ScherbakovAl/PIANO_G4_cbt6/ibis model/stm32g4_ibis/readme.txt

************************************************************************************
* @file     Readme.txt                                                              
* @author   MCD Application Team                                                    
* @version  V4.0                                                                    
* @date     29-July-2024                                                          
* @brief    I/O Buffer Information Specification (IBIS) files for the STM32G4 MCUs.    
************************************************************************************
* COPYRIGHT(c) 2024 STMicroelectronics                                             
*                                                                                  
* Redistribution and use in source and binary forms, with or without modification, 
* are permitted provided that the following conditions are met:                    
*   1. Redistributions of source code must retain the above copyright notice,      
*      this list of conditions and the following disclaimer.                       
*   2. Redistributions in binary form must reproduce the above copyright notice,   
*      this list of conditions and the following disclaimer in the documentation  
*      and/or other materials provided with the distribution.                      
*   3. Neither the name of STMicroelectronics nor the names of its contributors    
*      may be used to endorse or promote products derived from this software       
*      without specific prior written permission.                                  
*                                                                                  
* THIS SOFTWARE IS PROVIDED BY THE COPYRIGHT HOLDERS AND CONTRIBUTORS "AS IS"      
* AND ANY EXPRESS OR IMPLIED WARRANTIES, INCLUDING, BUT NOT LIMITED TO, THE        
* IMPLIED WARRANTIES OF MERCHANTABILITY AND FITNESS FOR A PARTICULAR PURPOSE ARE   
* DISCLAIMED. IN NO EVENT SHALL THE COPYRIGHT HOLDER OR CONTRIBUTORS BE LIABLE     
* FOR ANY DIRECT, INDIRECT, INCIDENTAL, SPECIAL, EXEMPLARY, OR CONSEQUENTIAL       
* DAMAGES (INCLUDING, BUT NOT LIMITED TO, PROCUREMENT OF SUBSTITUTE GOODS OR       
* SERVICES; LOSS OF USE, DATA, OR PROFITS; OR BUSINESS INTERRUPTION) HOWEVER       
* CAUSED AND ON ANY THEORY OF LIABILITY, WHETHER IN CONTRACT, STRICT LIABILITY,    
* OR TORT (INCLUDING NEGLIGENCE OR OTHERWISE) ARISING IN ANY WAY OUT OF THE USE    
* OF THIS SOFTWARE, EVEN IF ADVISED OF THE POSSIBILITY OF SUCH DAMAGE.             
***********************************************************************************

===============================
IBIS files for STM32G4 devices:
===============================

The package contains :

   + IBIS Files for STM32G431_441 devices on different packages :

	  o LQFP100
	  o LQFP80
	  o LQFP64
	  o LQFP48
	  o LQFP32
	  o UFBGA64
	  o UFQFPN48
	  o UFQFPN32
	  o WLCSP49

   + IBIS Files for STM32G471_473_474_483_484 devices on different packages :

          o LQFP128
	  o LQFP100
	  o LQFP80
	  o LQFP64
	  o LQFP48
	  o TFBGA100
	  o UFQFPN48
	  o WLCSP81
	  
   + IBIS Files for STM32G491_4A1 devices on different packages :

	  o LQFP100
	  o LQFP80
	  o LQFP64
	  o LQFP48
	  o UFBGA64
	  o UFQFPN48
	  o UFQFPN32
	  o WLCSP64
	  
=========================
* V4.0 - 29-July-2024  
=========================
 + Updating the naming of IBIS files for STM32G491_4a1 devices.
 + Updating of IBIS files for STM32G491_4a1 devices specifically LQFP48 package.
 + Updating of IBIS files for STM32G471_473_474_483_484 devices specifically LQFP48 package.

=========================
* V3.0 - 12-February-2021  
=========================
    + Created with IBIS files for STM32G4a1 devices.
	
=====================
* V2.0 - 24-July 2020 
=====================
    + Created with IBIS files for STM32G491 devices.
	
=====================
* V1.0 - 19-July-2019 
=====================
    + Created with IBIS files for STM32G471_473_474_483_484 and STM32G431_441 devices.

************** (C) COPYRIGHT 2024 STMicroelectronics **************
                          END OF FILE
