ScherbakovAl/PIANO_G4_cbt6/G4_bootloader/ПЕРЕХОД_C_CPP.md

# Объяснение ошибок при переходе с .c на .cpp

## Основные причины ошибок

Когда вы меняете расширение файла с `.c` на `.cpp`, компилятор переключается с C на C++, и это приводит к следующим проблемам:

### 1. **Name Mangling (Искажение имен)**

В C++ компилятор изменяет имена функций для поддержки перегрузки функций. Например:
- C: `void myFunction()` → `myFunction`
- C++: `void myFunction()` → `_Z10myFunctionv`

**Решение:** Использовать `extern "C"` для функций, которые должны вызываться из C кода:

```cpp
#ifdef __cplusplus
extern "C" {
#endif

void g4_bootloader();
void USART2_IRQ();
// ... другие функции

#ifdef __cplusplus
}
#endif
```

### 2. **Строгая типизация**

C++ гораздо строже проверяет типы, чем C:

#### Проблема с volatile указателями:
```cpp
volatile uint8_t* ChipNumber;
uint8_t* pData;

// В C работает:
Read(Address, ChipNumber, Size);

// В C++ ошибка: invalid conversion from 'volatile uint8_t*' to 'uint8_t*'
```

**Решение:** Использовать `const_cast`:
```cpp
Read(Address, const_cast<uint8_t*>(ChipNumber), Size);
```

#### Проблема с несовместимыми типами указателей:
```cpp
uint8_t* ChipN;   // указатель на uint8_t
uint64_t* Data;   // указатель на uint64_t

// В C работает (с предупреждением):
Flash(Address, ChipN, Size);

// В C++ ошибка: cannot convert 'uint8_t*' to 'uint64_t*'
```

**Решение:** Использовать `reinterpret_cast`:
```cpp
Flash(Address, reinterpret_cast<uint64_t*>(ChipN), Size);
```

### 3. **Настройка системы сборки CMake**

При использовании C++ необходимо:

1. **Включить поддержку C++:**
```cmake
enable_language(C CXX ASM)
```

2. **Установить стандарт C++:**
```cmake
set(CMAKE_CXX_STANDARD 17)
set(CMAKE_CXX_STANDARD_REQUIRED ON)
set(CMAKE_CXX_EXTENSIONS ON)
```

3. **Обновить список исходных файлов:**
```cmake
target_sources(${CMAKE_PROJECT_NAME} PRIVATE
    Core/Src/g4_bootloader.cpp  # было .c
)
```

4. **Использовать правильный тулчейн при конфигурации:**
```bash
cmake -B build -DCMAKE_TOOLCHAIN_FILE=cmake/gcc-arm-none-eabi.cmake
```

## Выполненные изменения

### 1. [`CMakeLists.txt`](CMakeLists.txt)
- Добавлена поддержка C++ (`enable_language(C CXX ASM)`)
- Установлен стандарт C++17
- Изменен путь к файлу с `.c` на `.cpp`

### 2. [`Core/Inc/g4_bootloader.h`](Core/Inc/g4_bootloader.h)
- Добавлена декларация `void g4_bootloader();` в блок `extern "C"`
- Все функции уже были внутри `extern "C"` блока, что правильно

### 3. [`Core/Src/g4_bootloader.cpp`](Core/Src/g4_bootloader.cpp)
- Использован `const_cast<uint8_t*>(ChipNumber)` для преобразования volatile указателя
- Использован `reinterpret_cast<uint64_t*>(ChipN)` для преобразования типов указателей

## Рекомендации

### Использование C++ в встраиваемых системах

**Преимущества:**
- Классы и инкапсуляция
- Шаблоны для типобезопасного кода
- RAII для управления ресурсами
- Перегрузка функций и операторов

**Что нужно отключать:**
```cmake
set(CMAKE_CXX_FLAGS "${CMAKE_C_FLAGS} -fno-rtti -fno-exceptions -fno-threadsafe-statics")
```
- `-fno-rtti` - отключает RTTI (Run-Time Type Information)
- `-fno-exceptions` - отключает исключения
- `-fno-threadsafe-statics` - отключает защиту статических переменных в многопоточной среде

### Осторожно с приведением типов

Использование `reinterpret_cast` для преобразования `uint8_t*` в `uint64_t*` может быть опасным:

```cpp
// Лучше создать правильный тип сразу:
uint64_t ChipN_aligned = ChipN[0];
Flash(ADRESS_CHIP_NUMBER, &ChipN_aligned, sizeof(uint64_t));
```

Или изменить сигнатуру функции:
```cpp
void Flash(uint32_t Address, void* Data, uint32_t size);
```

## Полезные ссылки

- [C++ для встраиваемых систем](https://isocpp.org/wiki/faq/embedded-systems)
- [Mixing C and C++](https://isocpp.org/wiki/faq/mixing-c-and-cpp)
- [CMake для ARM](https://cmake.org/cmake/help/latest/manual/cmake-toolchains.7.html)
