ScherbakovAl/PIANO_G4_cbt6/pcb/PNG_G4/PCB_G4.png

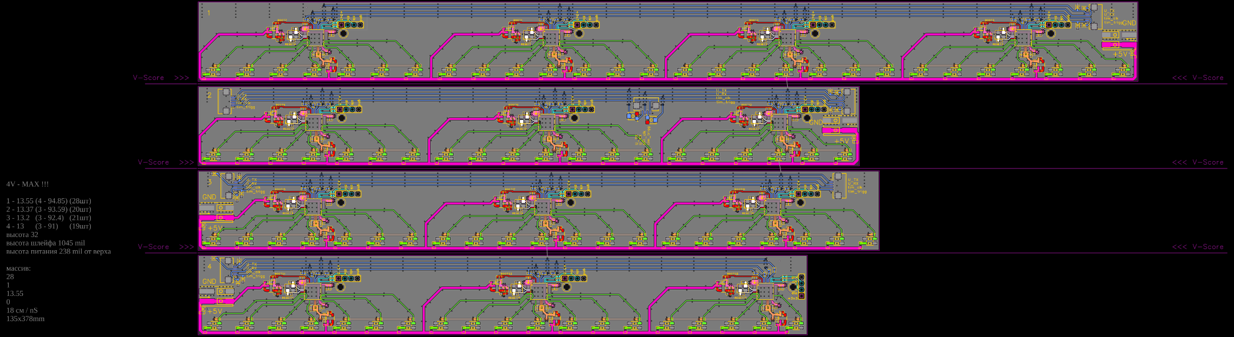
pcb/PNG_G4/PCB_G4.png
