ScherbakovAl/PIANO_G4_cbt6/pcb/PNG_G4/Schematic1/SCH_Schematic1_1-P1/SCH_reus5_1-P1_2026-06-18.png

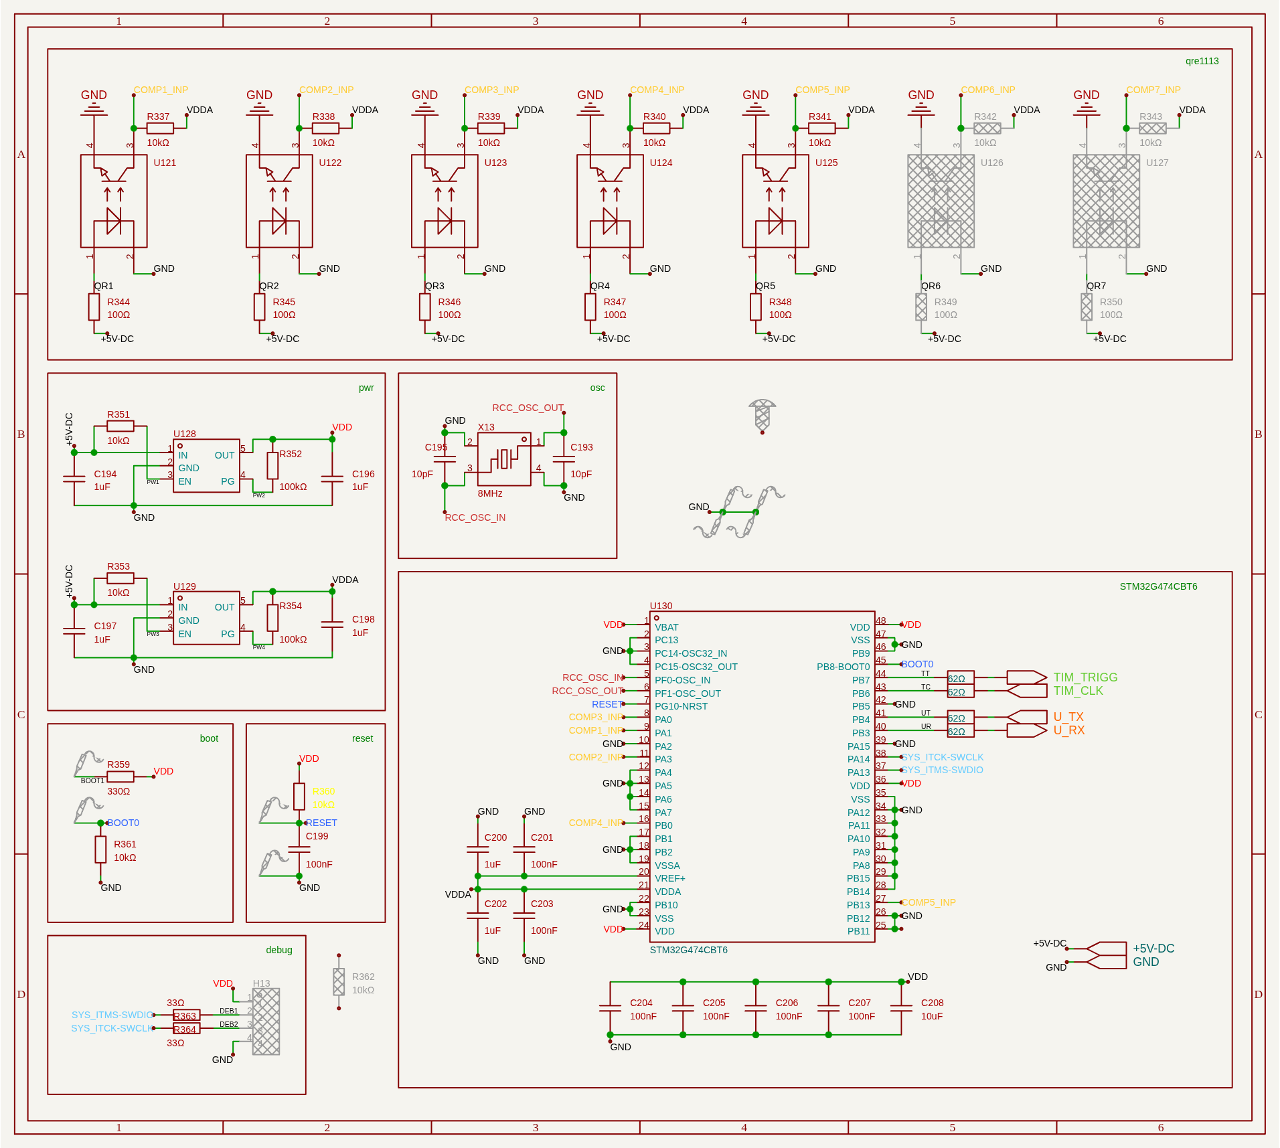
pcb/PNG_G4/Schematic1/SCH_Schematic1_1-P1/SCH_reus5_1-P1_2026-06-18.png
