ScherbakovAl/PIANO_G4_cbt6/pcb/PNG_G4/Schematic1/SCH_Schematic1_1-P1/SCH_reus_1-sch_2026-06-18_5.png

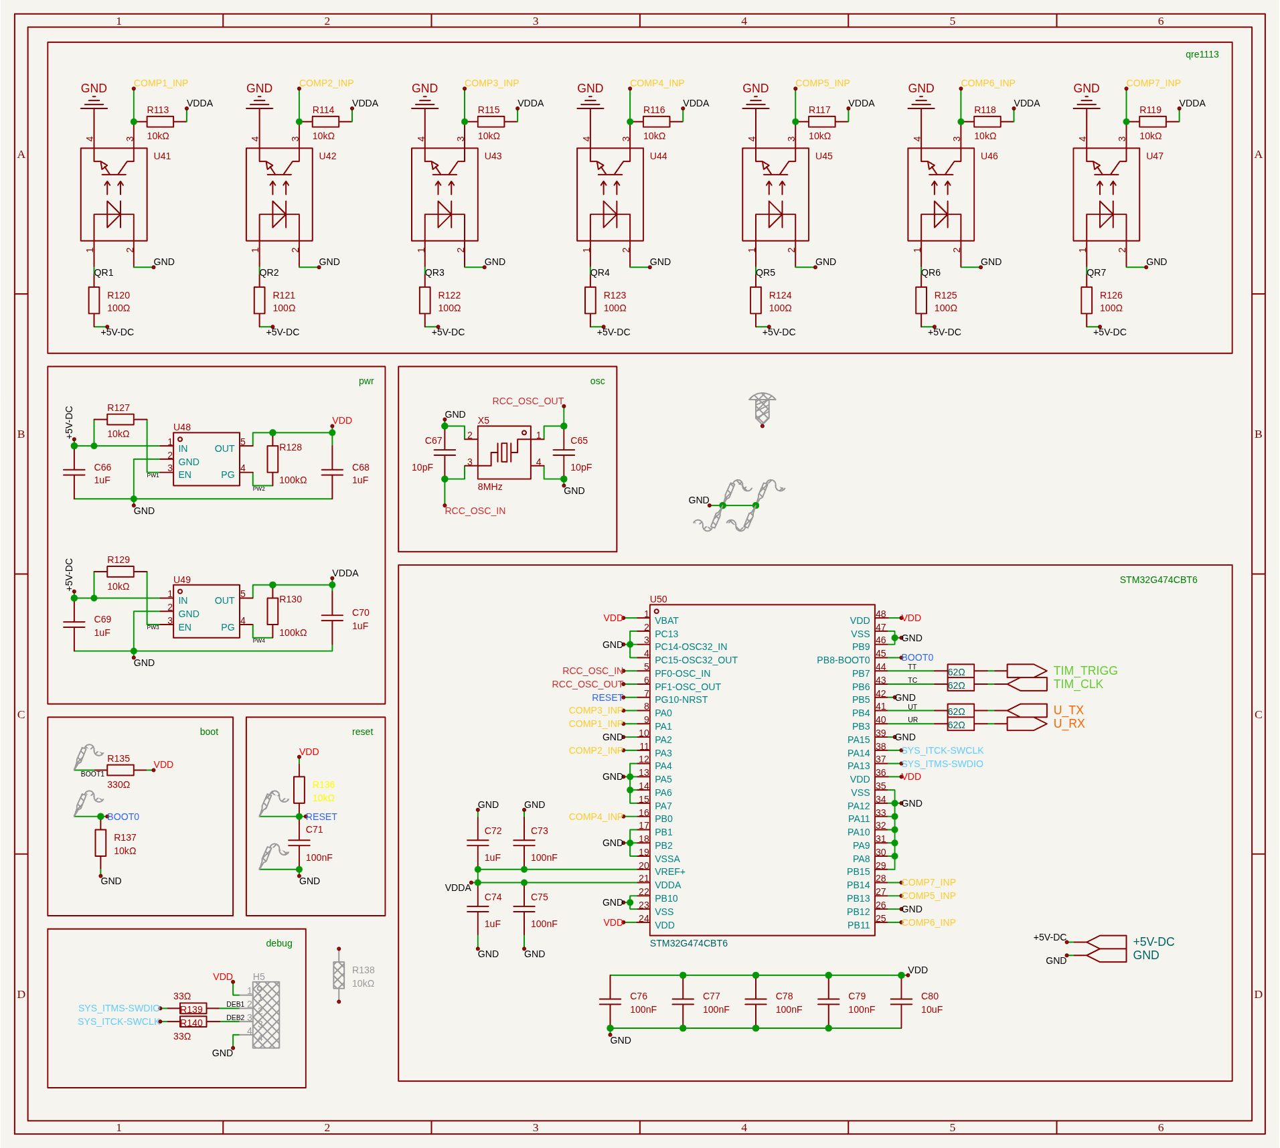
pcb/PNG_G4/Schematic1/SCH_Schematic1_1-P1/SCH_reus_1-sch_2026-06-18_5.png
