ScherbakovAl/PIANO_G4_cbt6/pcb/PNG_piano_boards_v1.0_(made)_G4/PCB_reus_G4.png

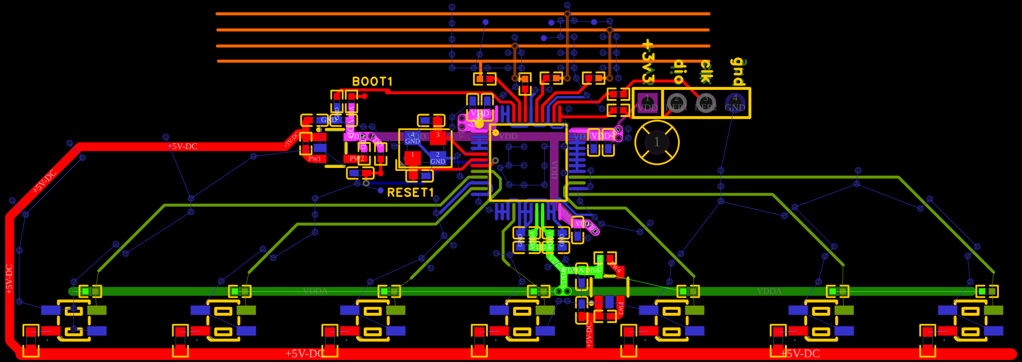
pcb/PNG_piano_boards_v1.0_(made)_G4/PCB_reus_G4.png
