ScherbakovAl/PIANO_G4_cbt6/pcb/PNG_piano_boards_v1.0_(made)_G4/Schematic1/SCH_Schematic1 1-P1/SCH_reus_1-sch_2026-06-18.png

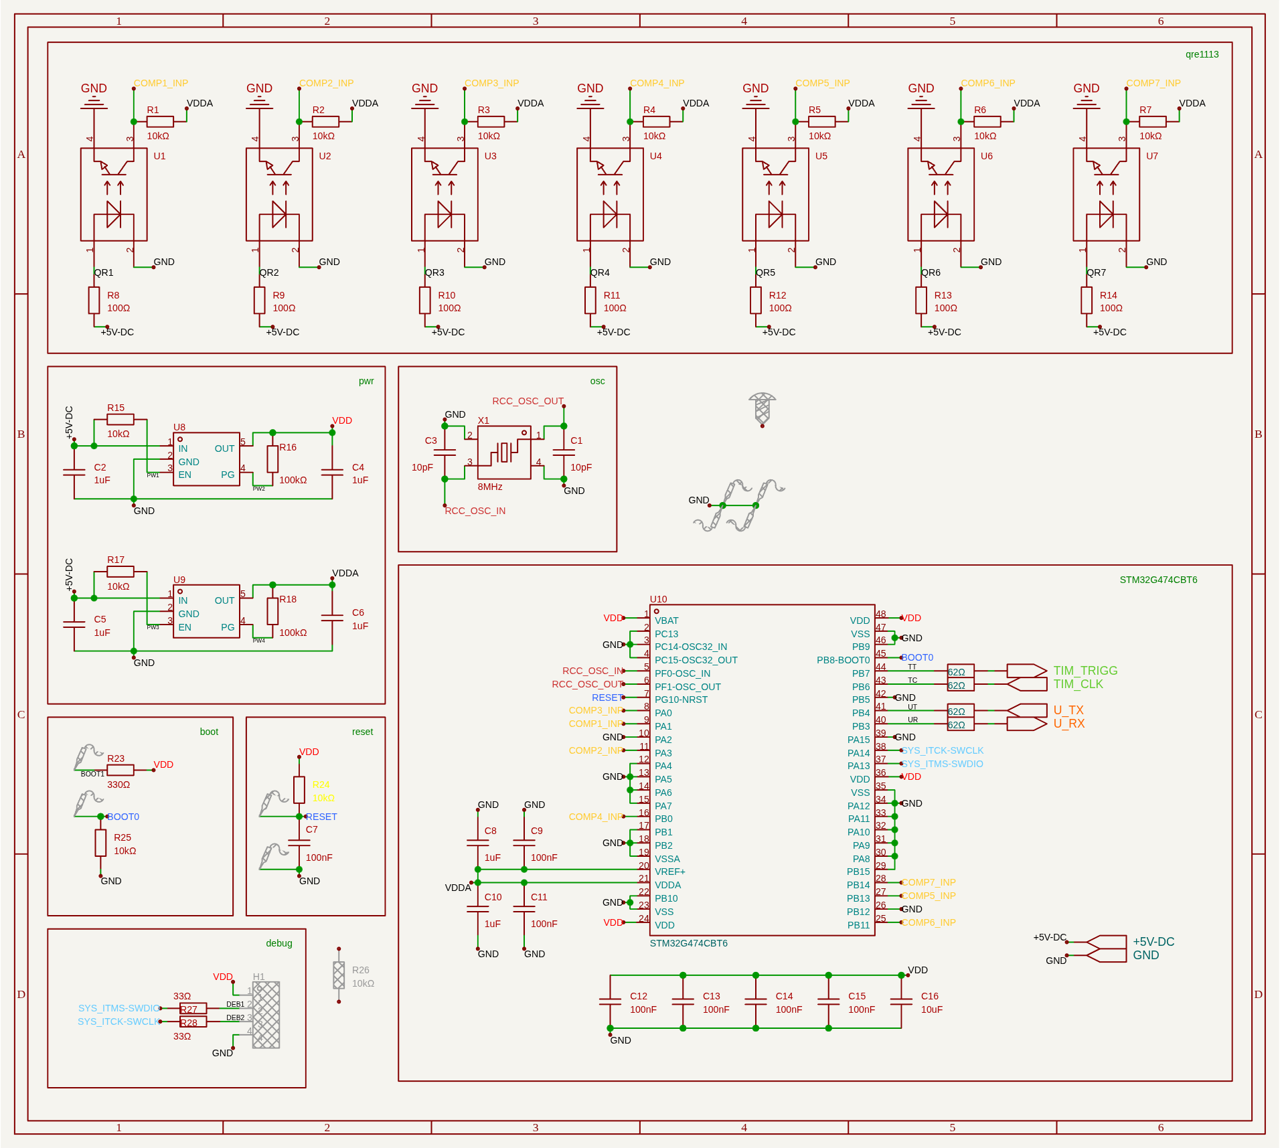
pcb/PNG_piano_boards_v1.0_(made)_G4/Schematic1/SCH_Schematic1 1-P1/SCH_reus_1-sch_2026-06-18.png
