ScherbakovAl/PIANO_G4_cbt6/pcb/BOM_Board_v1.0_Schematic_G4.xlsx

No. | Quantity | Comment | Designator | Footprint | Value | Manufacturer Part | Manufacturer | Supplier Part | Supplier
1 | 13 | oc2 | C1,C17,C33,C49,C65,C81,C97,C113,C129,C145,C161,C177,C193 | C0402 | 10pF | CC0402JRNPO9BN100 | YAGEO(国巨) | C106199 | LCSC
2 | 13 | p1c1 | C2,C18,C34,C50,C66,C82,C98,C114,C130,C146,C162,C178,C194 | C0402 | 1uF | CL05A105KA5NQNC | SAMSUNG(三星) | C52923 | LCSC
3 | 13 | oc1 | C3,C19,C35,C51,C67,C83,C99,C115,C131,C147,C163,C179,C195 | C0402 | 10pF | CC0402JRNPO9BN100 | YAGEO(国巨) | C106199 | LCSC
4 | 13 | p1c2 | C4,C20,C36,C52,C68,C84,C100,C116,C132,C148,C164,C180,C196 | C0402 | 1uF | CL05A105KA5NQNC | SAMSUNG(三星) | C52923 | LCSC
5 | 13 | p2c1 | C5,C21,C37,C53,C69,C85,C101,C117,C133,C149,C165,C181,C197 | C0402 | 1uF | CL05A105KA5NQNC | SAMSUNG(三星) | C52923 | LCSC
6 | 13 | p2c2 | C6,C22,C38,C54,C70,C86,C102,C118,C134,C150,C166,C182,C198 | C0402 | 1uF | CL05A105KA5NQNC | SAMSUNG(三星) | C52923 | LCSC
7 | 13 | rc | C7,C23,C39,C55,C71,C87,C103,C119,C135,C151,C167,C183,C199 | C0402 | 100nF | CL05B104KO5NNNC | SAMSUNG(三星) | C1525 | LCSC
8 | 13 | sc1 | C8,C24,C40,C56,C72,C88,C104,C120,C136,C152,C168,C184,C200 | C0402 | 1uF | CL05A105KA5NQNC | SAMSUNG(三星) | C52923 | LCSC
9 | 13 | sc2 | C9,C25,C41,C57,C73,C89,C105,C121,C137,C153,C169,C185,C201 | C0402 | 100nF | CL05B104KO5NNNC | SAMSUNG(三星) | C1525 | LCSC
10 | 13 | sc3 | C10,C26,C42,C58,C74,C90,C106,C122,C138,C154,C170,C186,C202 | C0402 | 1uF | CL05A105KA5NQNC | SAMSUNG(三星) | C52923 | LCSC
11 | 13 | sc4 | C11,C27,C43,C59,C75,C91,C107,C123,C139,C155,C171,C187,C203 | C0402 | 100nF | CL05B104KO5NNNC | SAMSUNG(三星) | C1525 | LCSC
12 | 13 | sc5 | C12,C28,C44,C60,C76,C92,C108,C124,C140,C156,C172,C188,C204 | C0402 | 100nF | CL05B104KO5NNNC | SAMSUNG(三星) | C1525 | LCSC
13 | 13 | sc6 | C13,C29,C45,C61,C77,C93,C109,C125,C141,C157,C173,C189,C205 | C0402 | 100nF | CL05B104KO5NNNC | SAMSUNG(三星) | C1525 | LCSC
14 | 13 | sc7 | C14,C30,C46,C62,C78,C94,C110,C126,C142,C158,C174,C190,C206 | C0402 | 100nF | CL05B104KO5NNNC | SAMSUNG(三星) | C1525 | LCSC
15 | 13 | sc8 | C15,C31,C47,C63,C79,C95,C111,C127,C143,C159,C175,C191,C207 | C0402 | 100nF | CL05B104KO5NNNC | SAMSUNG(三星) | C1525 | LCSC
16 | 13 | sc9 | C16,C32,C48,C64,C80,C96,C112,C128,C144,C160,C176,C192,C208 | C0402 | 10uF | CL05A106MQ5NUNC | SAMSUNG(三星) | C15525 | LCSC
17 | 4 | 4.7uF | C209,C210,C211,C212 | C0402 | 4.7uF | CL05A475MO5NUNC | SAMSUNG(三星) | C318563 | LCSC
18 | 16 | CDSOD323-T03C | D4,D5,D6,D8,D10,D11,D12,D13,D15,D16,D17,D19,D21,D22,D23,D24 | SOD-323_L1.8-W1.3-LS2.5-BI |  | CDSOD323-T03C | BOURNS | C711705 | LCSC
19 | 4 | CDSOD323-T05C | D7,D9,D18,D20 | SOD-323_L1.8-W1.3-LS2.5-BI |  | CDSOD323-T05C | BOURNS | C711706 | LCSC
20 | 88 | qr2 | R1,R2,R3,R4,R5,R6,R7,R29,R30,R31,R32,R33,R34,R35,R57,R58,R59,R60,R61,R62,R63,R85,R86,R87,R88,R89,R90,R91,R113,R114,R115,R116,R117,R118,R119,R141,R142,R143,R144,R145,R146,R147,R169,R170,R171,R172,R173,R174,R197,R198,R199,R200,R201,R202,R203,R225,R226,R227,R228,R229,R230,R231,R253,R254,R255,R256,R257,R258,R259,R281,R282,R283,R284,R285,R286,R287,R309,R310,R311,R312,R313,R314,R315,R337,R338,R339,R340,R341 | R0402 | 10kΩ | RC0402FR-0710KL | YAGEO(国巨) | C60490 | LCSC
21 | 88 | qr1 | R8,R9,R10,R11,R12,R13,R14,R36,R37,R38,R39,R40,R41,R42,R64,R65,R66,R67,R68,R69,R70,R92,R93,R94,R95,R96,R97,R98,R120,R121,R122,R123,R124,R125,R126,R148,R149,R150,R151,R152,R153,R154,R176,R177,R178,R179,R180,R181,R204,R205,R206,R207,R208,R209,R210,R232,R233,R234,R235,R236,R237,R238,R260,R261,R262,R263,R264,R265,R266,R288,R289,R290,R291,R292,R293,R294,R316,R317,R318,R319,R320,R321,R322,R344,R345,R346,R347,R348 | R0603 | 100Ω | RC0603FR-07100RL | YAGEO(国巨) | C105588 | LCSC
22 | 13 | p1r1 | R15,R43,R71,R99,R127,R155,R183,R211,R239,R267,R295,R323,R351 | R0402 | 10kΩ | RC0402FR-0710KL | YAGEO(国巨) | C60490 | LCSC
23 | 13 | p1r2 | R16,R44,R72,R100,R128,R156,R184,R212,R240,R268,R296,R324,R352 | R0402 | 100kΩ | RC0402FR-07100KL | YAGEO(国巨) | C60491 | LCSC
24 | 13 | p2r1 | R17,R45,R73,R101,R129,R157,R185,R213,R241,R269,R297,R325,R353 | R0402 | 10kΩ | RC0402FR-0710KL | YAGEO(国巨) | C60490 | LCSC
25 | 13 | p2r2 | R18,R46,R74,R102,R130,R158,R186,R214,R242,R270,R298,R326,R354 | R0402 | 100kΩ | RC0402FR-07100KL | YAGEO(国巨) | C60491 | LCSC
26 | 52 | 62Ω | R19,R20,R21,R22,R47,R48,R49,R50,R75,R76,R77,R78,R103,R104,R105,R106,R131,R132,R133,R134,R159,R160,R161,R162,R187,R188,R189,R190,R215,R216,R217,R218,R243,R244,R245,R246,R271,R272,R273,R274,R299,R300,R301,R302,R327,R328,R329,R330,R355,R356,R357,R358 | R0402 | 62Ω | FRC0402F62R0TS | FOJAN(富捷) | C2909376 | LCSC
27 | 13 | br1 | R23,R51,R79,R107,R135,R163,R191,R219,R247,R275,R303,R331,R359 | R0402 | 330Ω | RC0402FR-07330RL | YAGEO(国巨) | C105875 | LCSC
28 | 13 | rr | R24,R52,R80,R108,R136,R164,R192,R220,R248,R276,R304,R332,R360 | R0402 | 10kΩ | RC0402FR-0710KL | YAGEO(国巨) | C60490 | LCSC
29 | 13 | br2 | R25,R53,R81,R109,R137,R165,R193,R221,R249,R277,R305,R333,R361 | R0402 | 10kΩ | RC0402FR-0710KL | YAGEO(国巨) | C60490 | LCSC
30 | 13 | dr1 | R27,R55,R83,R111,R139,R167,R195,R223,R251,R279,R307,R335,R363 | R0402 | 33Ω | RC0402FR-0733RL | YAGEO(国巨) | C138002 | LCSC
31 | 13 | dr2 | R28,R56,R84,R112,R140,R168,R196,R224,R252,R280,R308,R336,R364 | R0402 | 33Ω | RC0402FR-0733RL | YAGEO(国巨) | C138002 | LCSC
32 | 88 | q | U1,U2,U3,U4,U5,U6,U7,U11,U12,U13,U14,U15,U16,U17,U21,U22,U23,U24,U25,U26,U27,U31,U32,U33,U34,U35,U36,U37,U41,U42,U43,U44,U45,U46,U47,U51,U52,U53,U54,U55,U56,U57,U61,U62,U63,U64,U65,U66,U71,U72,U73,U74,U75,U76,U77,U81,U82,U83,U84,U85,U86,U87,U91,U92,U93,U94,U95,U96,U97,U101,U102,U103,U104,U105,U106,U107,U111,U112,U113,U114,U115,U116,U117,U121,U122,U123,U124,U125 | OPTO-SMD_QRE1113GR |  | QRE1113GR | onsemi(安森美) | C232862 | LCSC
33 | 13 | p1 | U8,U18,U28,U38,U48,U58,U68,U78,U88,U98,U108,U118,U128 | TSOT-23-5_L2.9-W1.6-P0.95-LS2.8-BR |  | LDLN030G33R | ST(意法半导体) | C2688672 | LCSC
34 | 13 | p2 | U9,U19,U29,U39,U49,U59,U69,U79,U89,U99,U109,U119,U129 | TSOT-23-5_L2.9-W1.6-P0.95-LS2.8-BR |  | LDLN030G33R | ST(意法半导体) | C2688672 | LCSC
35 | 13 | STM32G474CBT6 | U10,U20,U30,U40,U50,U60,U70,U80,U90,U100,U110,U120,U130 | LQFP-48_L7.0-W7.0-P0.50-LS9.0-BL |  | STM32G474CBT6 | ST(意法半导体) | C730123 | LCSC
36 | 4 | 2060-452/998-404 | U131,U132,U139,U140 | CONN-SMD_2060-452 |  | 2060-452/998-404 | WAGO(万可) | C2765055 | LCSC
37 | 7 | AFD01-S09FCA-00 | U133,U134,U135,U136,U141,U142,U143 | FPC-SMD_9P-P0.50_JS_AFD01-S09FCA-00 |  | AFD01-S09FCA-00 | JS(钜硕电子) | C18198577 | LCSC
38 | 2 | 200Ω | U137,U138 | RES-ADJ-SMD_TC33X-2-104E | 200Ω | TC33X-2-201E | BOURNS | C720646 | LCSC
39 | 13 | o | X1,X2,X3,X4,X5,X6,X7,X8,X9,X10,X11,X12,X13 | CRYSTAL-SMD_4P-L3.2-W2.5-BL-1 | 8MHz | 3225-8.00-10-10-10/A | LIMING(利明) | C518154 | LCSC
