ScherbakovAl/PIANO_G4_cbt6/kicad_for_test_impedance/kicad_test_impedance/kicad_test_impedance.kicad_sch

## KiCad design kicad_for_test_impedance/kicad_test_impedance/kicad_test_impedance.kicad_sch (2026-01-01, an earlier design)

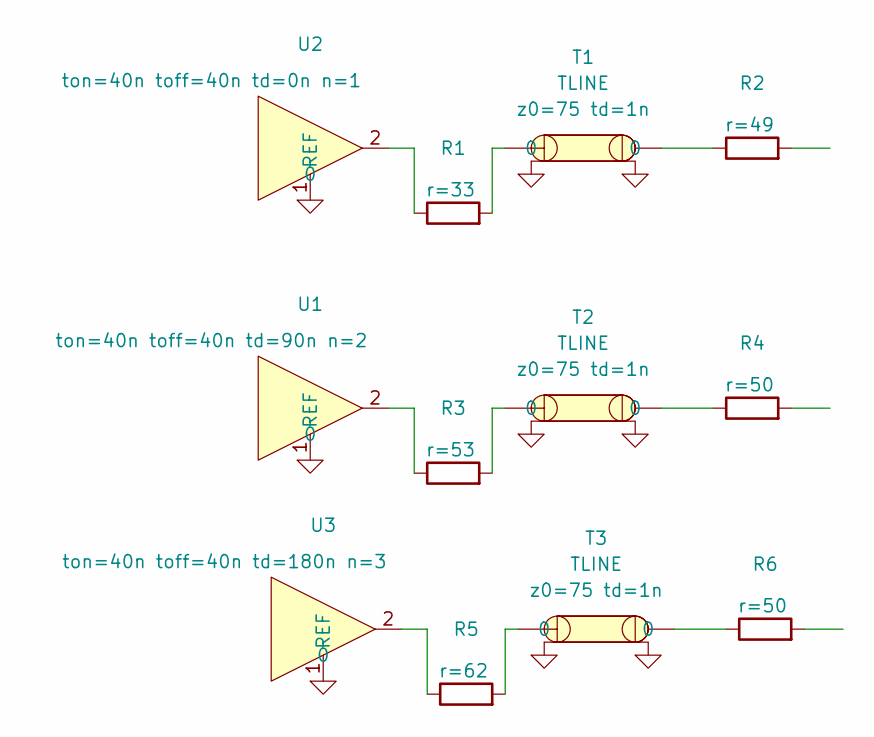
[picture p9: schematic kicad_test_impedance.kicad_sch]

Parts:
R1: r=33
R2: r=49
R3: r=53
R4, R6: r=50
R5: r=62
T1, T2, T3: TLINE
U1, U2, U3: IBIS_DRIVER

Connections:
0: T1.2, T1.4, T2.2, T2.4, T3.2, T3.4, U1.1 (REF), U2.1 (REF), U3.1 (REF)
unnamed: R1.1, U2.2
unnamed: R1.2, T1.1
unnamed: R2.1, T1.3
unnamed: R3.1, U1.2
unnamed: R3.2, T2.1
unnamed: R4.1, T2.3
unnamed: R5.1, U3.2
unnamed: R5.2, T3.1
unnamed: R6.1, T3.3
