ScherbakovAl/PIANO_G4_cbt6/ibis model/kicad test/kicad-test_ibis.kicad_sch

## KiCad design ibis model/kicad test/kicad-test_ibis.kicad_sch (2026-01-01)

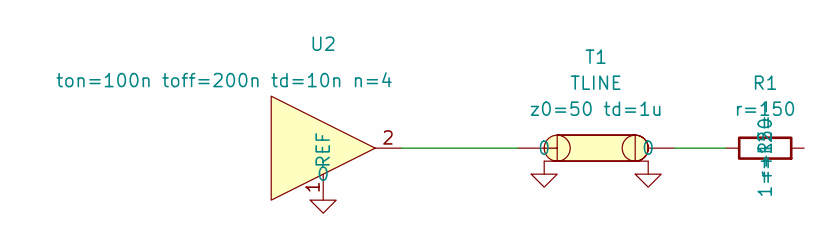
[picture p10: schematic kicad-test_ibis.kicad_sch]

Parts:
R1: r=150
T1: TLINE
U2: IBIS_DRIVER

Connections:
0: T1.2, T1.4, U2.1 (REF)
unnamed: R1.1, T1.3
unnamed: T1.1, U2.2
