ScherbakovAl/PIANO_G4_cbt6/PIANO_G4_cbt6.ioc

Mcu.UserName=STM32G474CBTx
PA0.Signal=COMP3_INP
PA1.Signal=COMP1_INP
PA10.Signal=GPIO_Analog
PA11.Signal=GPIO_Analog
PA12.Signal=GPIO_Analog
PA13.Signal=SYS_JTMS-SWDIO
PA14.Signal=SYS_JTCK-SWCLK
PA15.Signal=GPIO_Analog
PA2.Signal=GPIO_Analog
PA3.Signal=COMP2_INP
PA4.Signal=GPIO_Analog
PA5.Signal=GPIO_Analog
PA6.Signal=GPIO_Analog
PA7.Signal=GPIO_Analog
PA8.Signal=GPIO_Analog
PA9.Signal=GPIO_Analog
PB0.Signal=COMP4_INP
PB1.Signal=GPIO_Analog
PB10.Signal=GPIO_Analog
PB11.Signal=COMP6_INP
PB12.Signal=GPIO_Analog
PB13.Signal=COMP5_INP
PB14.Signal=COMP7_INP
PB15.Signal=GPIO_Analog
PB2.Signal=GPIO_Analog
PB3.Signal=USART2_TX
PB4.Signal=USART2_RX
PB5.Signal=GPIO_Analog
PB6.GPIO_Label=TIM_CLK(TIM8_ETR)
PB6.Signal=S_TIM8_ETR
PB7.GPIO_Label=TIM_trigg
PB7.Signal=GPIO_Output
PB8-BOOT0.GPIO_Label=GPIO_Analog(BOOT vvv)
PB8-BOOT0.Signal=GPIO_Analog
PB9.Signal=GPIO_Analog
PC13.Signal=GPIO_Analog
PC14-OSC32_IN.Signal=GPIO_Analog
PC15-OSC32_OUT.Signal=GPIO_Analog
PF0-OSC_IN.Signal=RCC_OSC_IN
PF1-OSC_OUT.Signal=RCC_OSC_OUT
PG10-NRST.Signal=GPIO_Analog
