ScherbakovAl/PIANO_G4_cbt6/Core/Inc/main.h

#define TIM_CLK_Pin LL_GPIO_PIN_6
#define TIM_CLK_GPIO_Port GPIOB
#define TIM_trigg_Pin LL_GPIO_PIN_7
#define TIM_trigg_GPIO_Port GPIOB
#define GPIO_Analog_Pin LL_GPIO_PIN_8
#define GPIO_Analog_GPIO_Port GPIOB
