ScherbakovAl/PIANO_G4_cbt6/(commit log)

2025-06-01 прекрасно всё работает!
2025-06-22 протестировать analog mode!
2025-06-30 analog mode работает
2025-09-08 переезжаем на новые платы
2025-09-11 add noteOff & передача timerLenght -> uint32_t
2025-09-21 note OFF работает
2025-09-24 вроде работает, но H7 ещё теряет сигнал. Понижена скорость uart
2025-09-25 требуется!! проверить изменения добавленные в этом коммите(работоспособность сейчас непонятна...)
2025-09-26 подключены все платы - работает
2025-09-27 понизил скорость uart и работает даже с миди
2025-09-27 убрал лишний код (прерывания и дма)
2025-09-27 многократно ускорил калибровку, но надо ещё распространить на все чипы это..
2025-09-28 некоторые оптимизации
2025-09-28 готово к установке и калибровке
2025-10-05 теперь всё нормально работает после выполнения калибровки
2025-10-05 dequeOn не очищать в прерывании!!
2025-10-06 прошил откалибровал и поиграл!
2025-10-08 update for note off (видимо теперь прекрасно должно работать без залипающих демпферов)
2025-11-21 смотрел в код и думал) вроде всё в порядке
2025-12-30 add ibis models stm32g474
2026-01-01 kicad upd
2026-01-01 add kicad test impedance proj
2026-01-23 Надо применить изменения и перепрошить все чипы на платах
2026-01-27 добавлен к проекту код загрузчика (bootloader) - пока стадия становления
2026-01-27 подключил HAL (только для этого таймер добавил с HAL)
2026-01-27 >> как писать, читать, стирать falsh память загрузчиком..
2026-01-28 Прошивается, но если очищать память - не записывает после этого почему-то
2026-01-28 заработало запись и чтение Flash
2026-01-28 проверочки всякие
2026-01-29 продвигаемся с bootloader..
2026-01-29 собирается, надо тестить..
2026-01-30 началось общение между контроллерами
2026-01-30 данные прошивки передаются! H7->G4
2026-01-30 сохраняет массив в память, но только в режиме DEBUG
2026-01-31 зависает в Flash (403 стр)
2026-01-31 ИИ поправил код и flash работает
2026-01-31 рекомендации ИИ и примеры функций для uin32_t <->uint8_t
2026-01-31 bootloader данне принимает, но пока не прошивает в память
2026-01-31 поиск ошибки..
2026-01-31 Работает сохранение, но ещё проблема с проверкой..
2026-01-31 копируется нормально H7 >> G4
2026-02-01 Заработала прошивка на G4, но через перезагрузку..пока не прыгает в неё напрямую..
2026-02-01 ..ищем проблему, почему не запускается прыжком, а только при старте..
2026-02-01 ИИ порекомендовал, но пока не помогло.. код не стартует по принуждению, работает только если в начале прыжок происходит
2026-02-01 частично заработал запуск из бутлоадера G4
2026-02-01 рефакторинг, (непонятно как работает)
2026-02-02 Много изменений и рефакторинг
2026-02-02 заработала прошивка полученная через uart, но почему-то нужно перезагружать H7
2026-02-02 заработала прошивка переданная по uart! (переходы по меню требуют уточнения)
2026-02-03 заработал бутлоадер
2026-02-03 ну более-менее работает централизованная загрузка прошивки на чипы
2026-02-05 TODO требует проработки - вариант прыжка в нужную функцию из прерывания
2026-02-13 залился на основную клавиатуру и вариант с бутлоадером работает!
2026-02-15 добавлен выбор нужной функции для обработки прерывания в зависимости от номера чипа
2026-02-16 вариант оптимизации
2026-02-17 рефакт
2026-02-17 оптимизации и рефакт
2026-02-23 добавлен второй бутлоадер
2026-06-06 docs: add bilingual README, MIT LICENSE, CITATION.cff with Zenodo DOI
    Document the G4 sensor-board firmware (optical digital MIDI piano),
    add MIT license and citation metadata (DOI 10.5281/zenodo.20569250).
2026-06-06 docs: add bilingual README, MIT LICENSE, CITATION.cff with Zenodo DOI
    add MIT license and citation metadata (concept DOI 10.5281/zenodo.20569249).
    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
2026-06-18 docs: add sensor-board PCB/3D/schematic images and README links
    Add 3D render, sensor-board PCB layout and sensor-board schematic
    (copied from the PIANO_H7 EasyEDA export) under pcb/, and reference
    them from the README (EN + RU). Note pcb/ in the repo layout.
2026-10-15 fix: pause() no longer resets TIM2 — it is the timestamp of key measurements
    A command arriving mid-stroke (pause() in USART2_Send) zeroed TIM2 between the
    two edges of a measurement and the interval came out wrong.
2026-10-15 refactor: ring buffer instead of std::deque; saturate the 24-bit time field
    std::deque pulled in new/delete (~1.6 KB flash: 14028 → 12384 B), room for the
    new OFF automaton. Intervals longer than 0x7FFFFE ticks (~0.86 s) are clamped
    instead of losing their high bits on the bus; bit 23 stays free for the damper
    lift flag.
2026-10-15 fix: reset automata in the main loop, not in the USART2 interrupt
    resetData() (sync_timer, cal) and set_comp_value ran from the USART2 ISR and
    rewrote f[]/DAC while the main loop was mid-step, and could not clear the
    event queue (old TODO). The ISR now only masks EXTI and sets need_reset; the
    main loop clears the queue and re-arms every comparator with its threshold
    and edge (comp_idle). set_comp_value used to leave the DAC on the old
    threshold with whatever edge was armed.
2026-10-15 feat(off): new OFF automaton — damper lift on R↓, note-off on R↑, no stuck notes
    The old cycle armed the press only at grey = green − green/40, the deepest
    threshold, ~50 codes below green, less than the 87-code comparator
    hysteresis. A quiet press that did not push the key that deep never started
    the cycle, so that note never got a note-off.
    Now (G = comp[i][0] < R = comp[i][1], grey unused):
    R↓ — damper leaves the strings; G↓ — key down: damper lift, speed = R↓→G↓
    G↑ (t0) → R↑ (t1) — damper lands: note-off, speed = t1−t0
    below R but not at G for 15 ms — lift without speed (shallow press),
    its release above R — note-off without speed (0x7FFFFF)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
2026-10-16 fix: main-loop USART2_Send could hang forever on the TC flag
    USART2_Send waits for TC, but the TC interrupt (end of an event transfer,
    USART2_IRQ) is always enabled and clears TC. Called from the main loop — at
    g4() start and on leaving calibration — the interrupt could win, and the main
    loop spun forever: an OFF chip never reached its loop (no OFF events; commands
    still answered from the ISR), and H7 hung waiting for the stop_calibration
    reply. The old code always won this race by its timing; reset_all() before
    these sends now varies with the comparator states. TC interrupt is masked
    for the duration of the send.
    That interrupt also used to drop an event still waiting for its bus slot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
2026-10-16 refactor: timeLength() is plain unsigned t2 - t1
    Unsigned subtraction already wraps modulo 2^32, so the separate branch for a
    TIM2 wrap gave the same result. Holds only while TIM2 ARR = 0xFFFFFFFF —
    noted in the comment.
2026-10-18 feat(capture): comparator timestamps by timer input capture, no interrupts
    Each COMP output is routed to a timer capture input (TISEL): COMP1,4,5,6 ->
    TIM2 CH4/3/1/2, COMP2,7 -> TIM5 CH2/1, COMP3 -> TIM3 CH1 (16-bit, extended
    to 32 bits from TIM2 in take()). The timer latches the edge itself, so ISR
    latency, chords and the USART2 handler no longer move the timestamp.
    - TIM2/TIM3/TIM5 PSC 0: 7.35 ns tick (was 102.9 ns), enough for 14-bit
    hi-res velocity on every H7 curve; the 23-bit bus field still holds 61.7 ms.
    - COMP EXTI lines and NVIC vectors are switched off in cap_init().
    - ON/OFF automata run only in the main loop on hardware timestamps; the
    30/50 ms windows count from the timest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
2026-10-18 fix: keep CRLF line endings in the CubeMX stm32g4xx_it.c
2026-10-18 план
2026-10-27 feat(on): G→R window 55 ms instead of 30 ms
    The slowest measured hammer flight reached 28.4 ms, close to the 30 ms
    window: slower presses were dropped without a note. 55 ms stays under the
    61.7 ms limit of the 23-bit time field on the bus.
